BenClark1/Pulser_Driver/Project Outputs for Pulser_Driver/Pulser_Driver.xlsx

Sheet: Manufacturing
 |  | Bill of Materials for |  | Pulser_Driver.PrjPcb
 |  | Source Data From: | Pulser_Driver.PrjPcb
 |  | Variant: | None
 |  | Report Date: | 2/16/2022 12:57 PM
 |  |  |  | Primary |  |  |  |  | Secondary
Altium Vault P/N | Designator | Description | Qty | Supplier | Supplier Part Number | Manufacturer | Manufacturer Part Number | Supplier Unit Price | Supplier | Supplier Part Number | Manufacturer | Manufacturer Part Number | Supplier Unit Price
C325C201K3G5TA | C5 | Capacitor 200 pF | 1
EEU-FS2A221B | C6 | Capacitor Polarised 100VDC 220uF 1800mA EEU-FS2A221B | 1
Cap | C7, C9 | Capacitor 0.1 µF ±10% 100V Ceramic Capacitor X7R Axial SA301C104KAA, Capacitor Capacitor 0.1 µF ±10% 100V Ceramic Capacitor X7R Axial SA301C104KAA | 2
MKS2D041001K00KSSD | C8 | Capacitor | 1
MKP1839468134HQ | C10 | Capacitor MKP1839468134HQ | 1
C331C222KHR5HA | C11 | Multilayer Ceramic Capacitors MLCC - Leaded 3000V 2200pF X7R 10% LS=6.35mm | 1
EEU-TP1V121 | C12 | Capacitor Polarised | 1
C420C104K5R5TA7200 | C13 | CAP CER TH 0.1UF 50V X7R AXIAL | 1
FKP1U021006B00MSC9 | C14 | Capacitor | 1
1N5819-E3_54 | D1 | Schottky Diode | 1
1N4933G | D2 | Rectifiers 50V 1A Fast | 1
DSDI60-18A | D3 | Diode | 1
4527 | F1, F2 | Undefined or Miscellaneous | 2
57-PJ60 | J1 |  | 1
031-5640 | J3 | Connector | 1
550-2407F | LED1 | LED | 1
MTHOLE_239MIL | MT1, MT2, MT3, MT4 |  | 4
C12 | PS3 | MPN is C12, DC DC conv | 1
AM2G-1218DH30Z | PS4 |  | 1
IXBX75N170 | Q1 | Transistor IGBT | 1
CMF551K0000FKR6 | R1 | Metal Film Resistors - Through Hole 1/2W 1Kohms 1% | 1
CMF5550R000FKEK70 | R2 | Resistor 50ohm | 1
F2W2D0 | R3 | RES TH 2 OHM 5% 2W AXIAL | 1
MFR-25FBF52-14K | R4 | RES TH 14K OHM 1% 1/4W AXIAL | 1
HHV1WSJT-73-2M | R5 | RES 2M OHM 5% 1W AXIAL | 1
HB3100MFZRE | R6 | Resistor | 1
OD62GJE | R7 | Resistor | 1
T102SHCQE | SW1 | Switch | 1
1984617 | TB1, TB2 | Connector | 2
5261 | TP1, TP2, TP3, TP4, TP5, TP6, TP7, TP8, TP9, TP10, TP11 | TEST POINT grabber (BLACK) - MINIATURE | 11
MIC4452YN | U1 |  | 1
P9A1R100FISX1103MA | VR1 | Variable Resistor 10K | 1

Sheet: Project Information
Project Full Path | C:\Users\jared\Documents\senior project\Pulser_Driver\Pulser_Driver.PrjPcb
Project Filename | Pulser_Driver.PrjPcb
Variant Name | None
Data-Source Filename | Pulser_Driver.PrjPcb
Data-Source Full Path | C:\Users\jared\Documents\senior project\Pulser_Driver\Pulser_Driver.PrjPcb
Title | Bill of Materials for Project [Pulser_Driver.PrjPcb] (No PCB Document Selected)
Total Quantity | 48
Report Time | 12:57 PM
Report Date | 2/16/2022
Report Date & Tine | 2/16/2022 12:57 PM
Output Name | Bill of Materials
Output Type | BomReport
Output Generator Name | BOM
Output Generator Description | Bill of Materials
