BenClark1/Pulser_Driver/component_step_files/C331C222KHR5HA.step

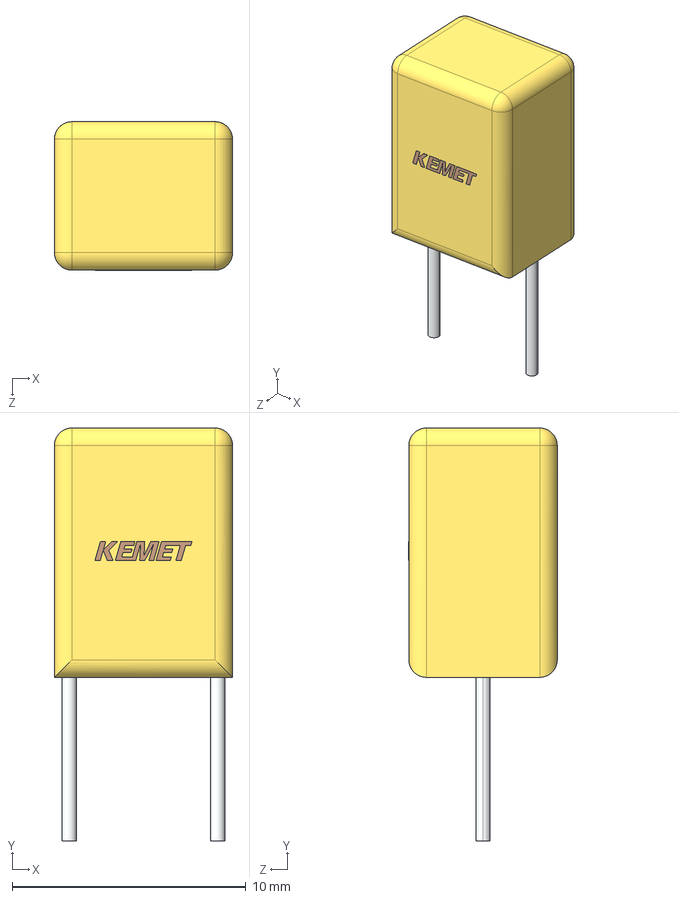
[picture p1: CAD file, 2022-02-02]
component_step_files/C331C222KHR5HA.step
7.62 x 17.7 x 6.35 mm
