BenClark1/Pulser_Driver/component_step_files/ul_MFR-25FBF52-14K/2022-01-13_22-12-16/STEP/YAG_MF25_YAG.step

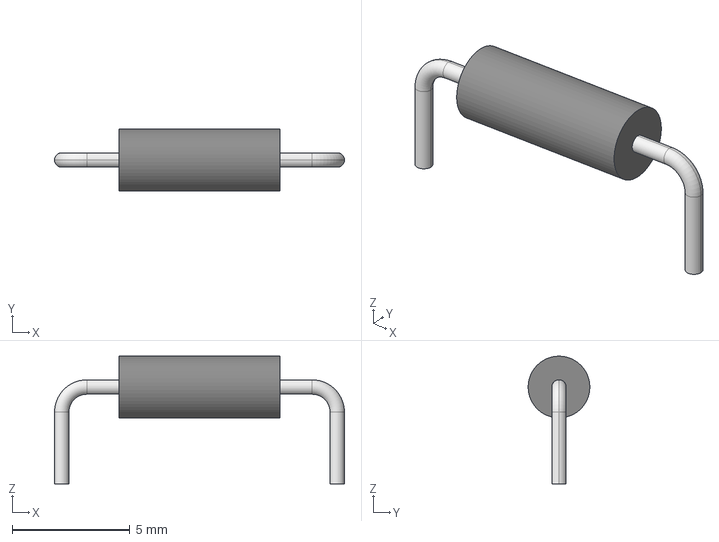
[picture p2: CAD file, 2022-01-13]
component_step_files/ul_MFR-25FBF52-14K/2022-01-13_22-12-16/STEP/YAG_MF25_YAG.step
12.3 x 2.61 x 5.41 mm
