BenClark1/Pulser_Driver/Pulser_Driver_PCB.step

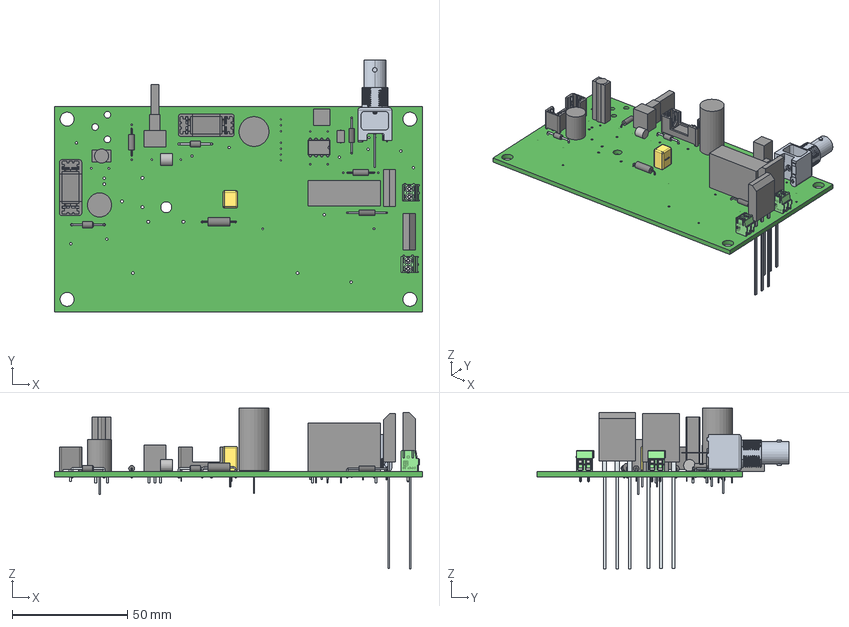
[picture p3: CAD file, 2022-02-24]
Pulser_Driver_PCB.step
159.8 x 109.3 x 69.7 mm
C331C222KHR5HA
Leads x 7
SimpleBody x 4
PinsArray x 2
YAG_MF25_YAG x 2
PinsArrayLR
YAG_HHV50_YAG
Pin1 x 2
Pin2 x 2
