BenClark1/Pulser_Driver/component_step_files/F462BY104K1L2C.step

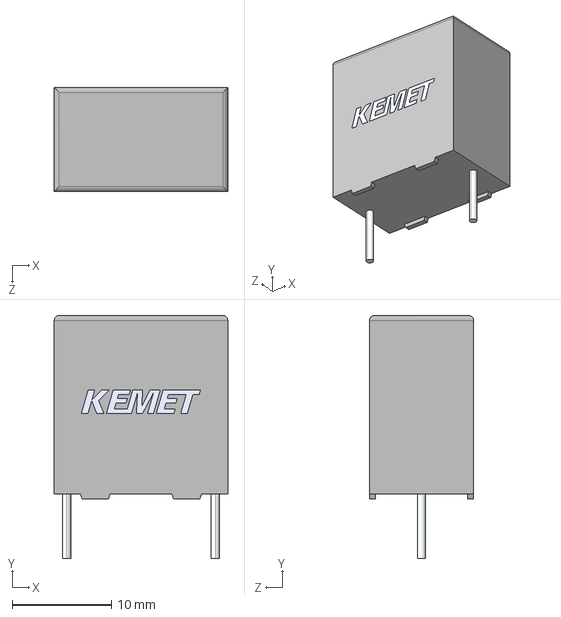
[picture p4: CAD file, 2022-02-01]
component_step_files/F462BY104K1L2C.step
17.5 x 24.5 x 10.5 mm
