BenClark1/Pulser_Driver/component_step_files/pwr220t-20.stp

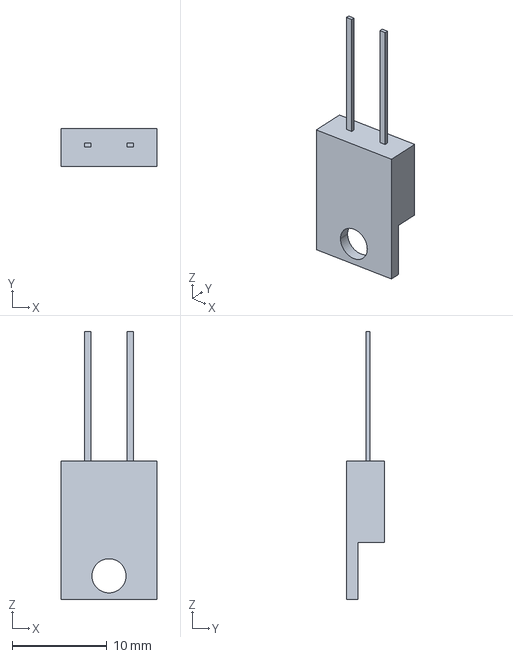
[picture p5: CAD file, 2022-01-26]
component_step_files/pwr220t-20.stp
10.1 x 4.00 x 28.3 mm
