BenClark1/Pulser_Driver/component_step_files/C420C104K5R5TA7200.step

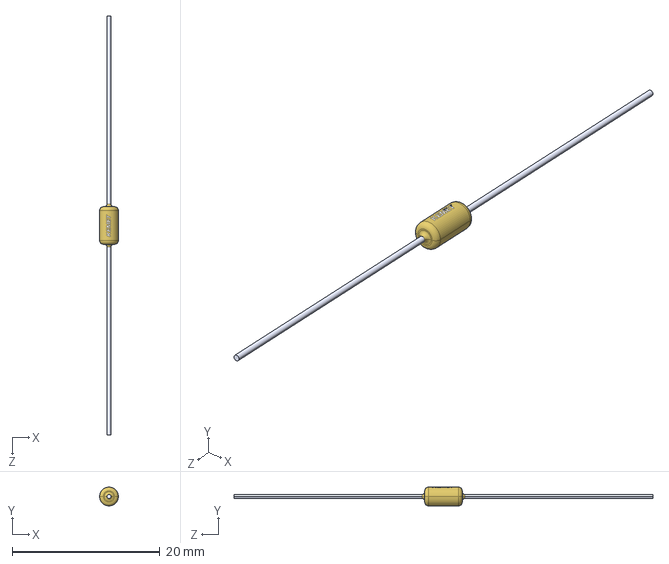
[picture p6: CAD file, 2022-01-13]
component_step_files/C420C104K5R5TA7200.step
2.54 x 2.54 x 56.6 mm
