BenClark1/Pulser_Driver/component_step_files/031-5640.stp

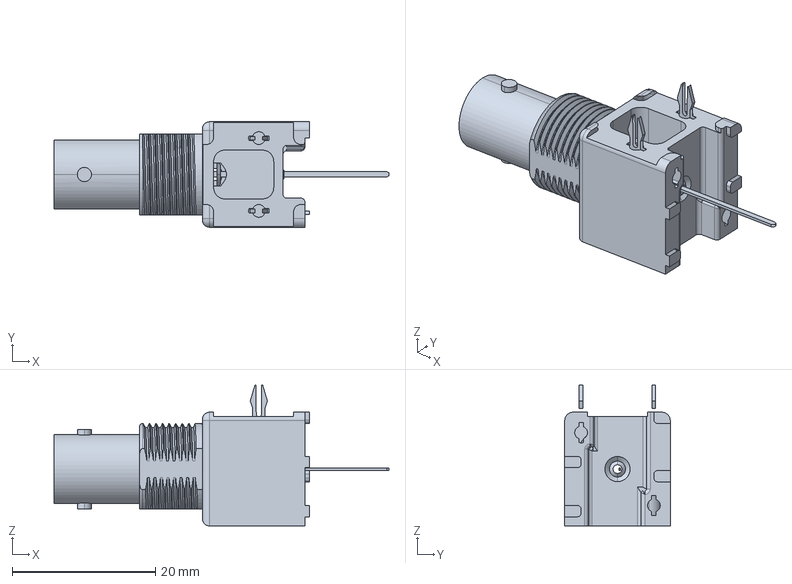
[picture p7: CAD file, 2022-01-06]
component_step_files/031-5640.stp
46.7 x 14.7 x 19.7 mm
