BenClark1/Pulser_Driver/(list of files, cad)

Other CAD files:
Pulser_Driver_PCB.DWG
