BenClark1/Pulser_Driver/Pulser_Driver.pdf

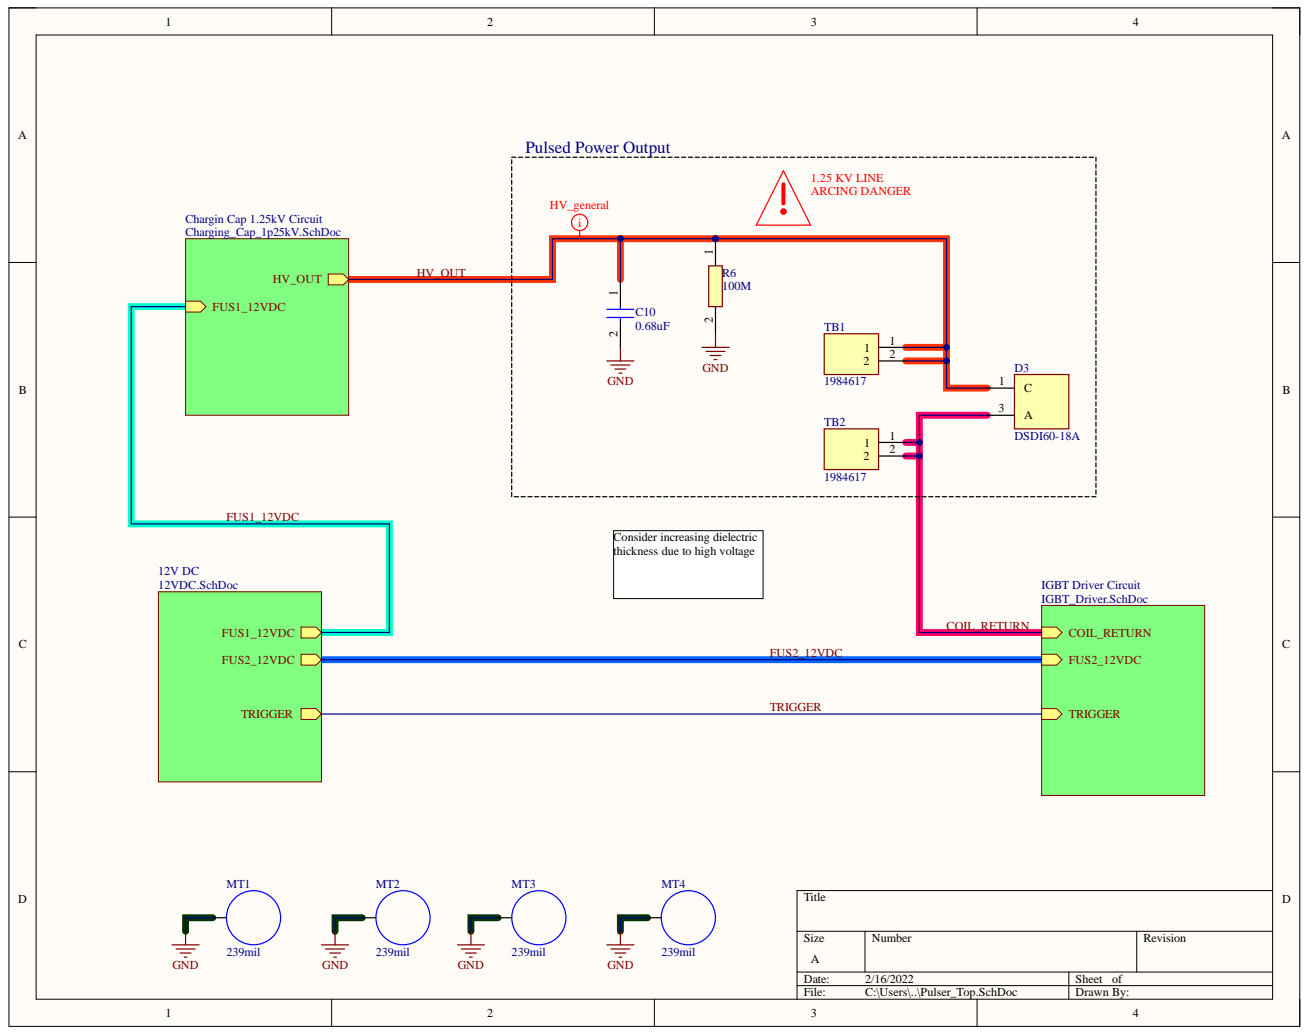
[picture p8: page 1]

Consider increasing dielectric
thickness due to high voltage

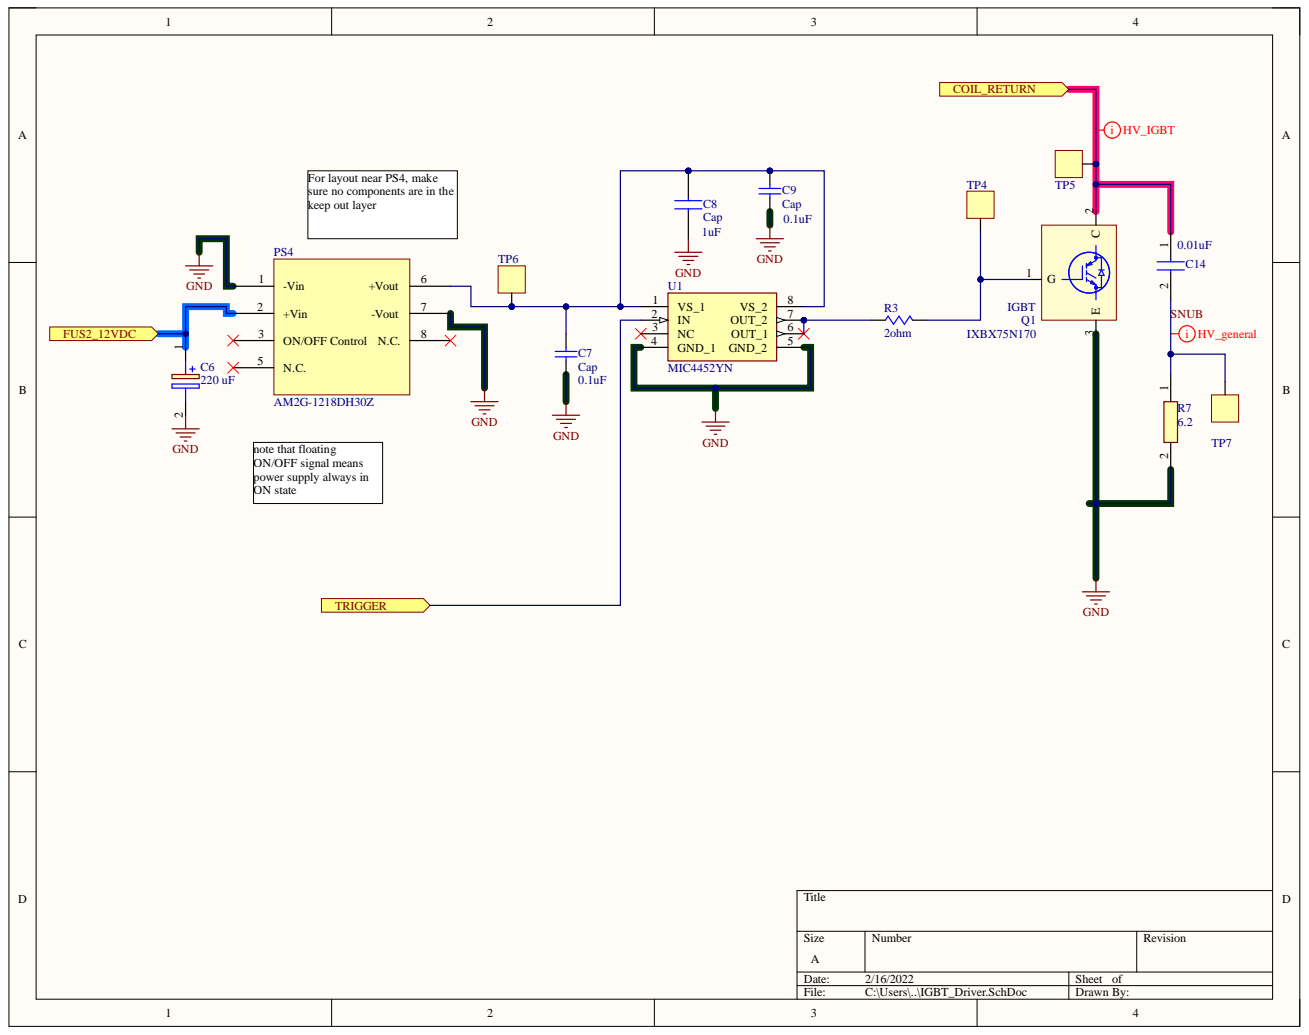
[picture p9: page 2]

For layout near PS4, make
sure no components are in the
keep out layer

note that floating
ON/OFF signal means
power supply always in
ON state

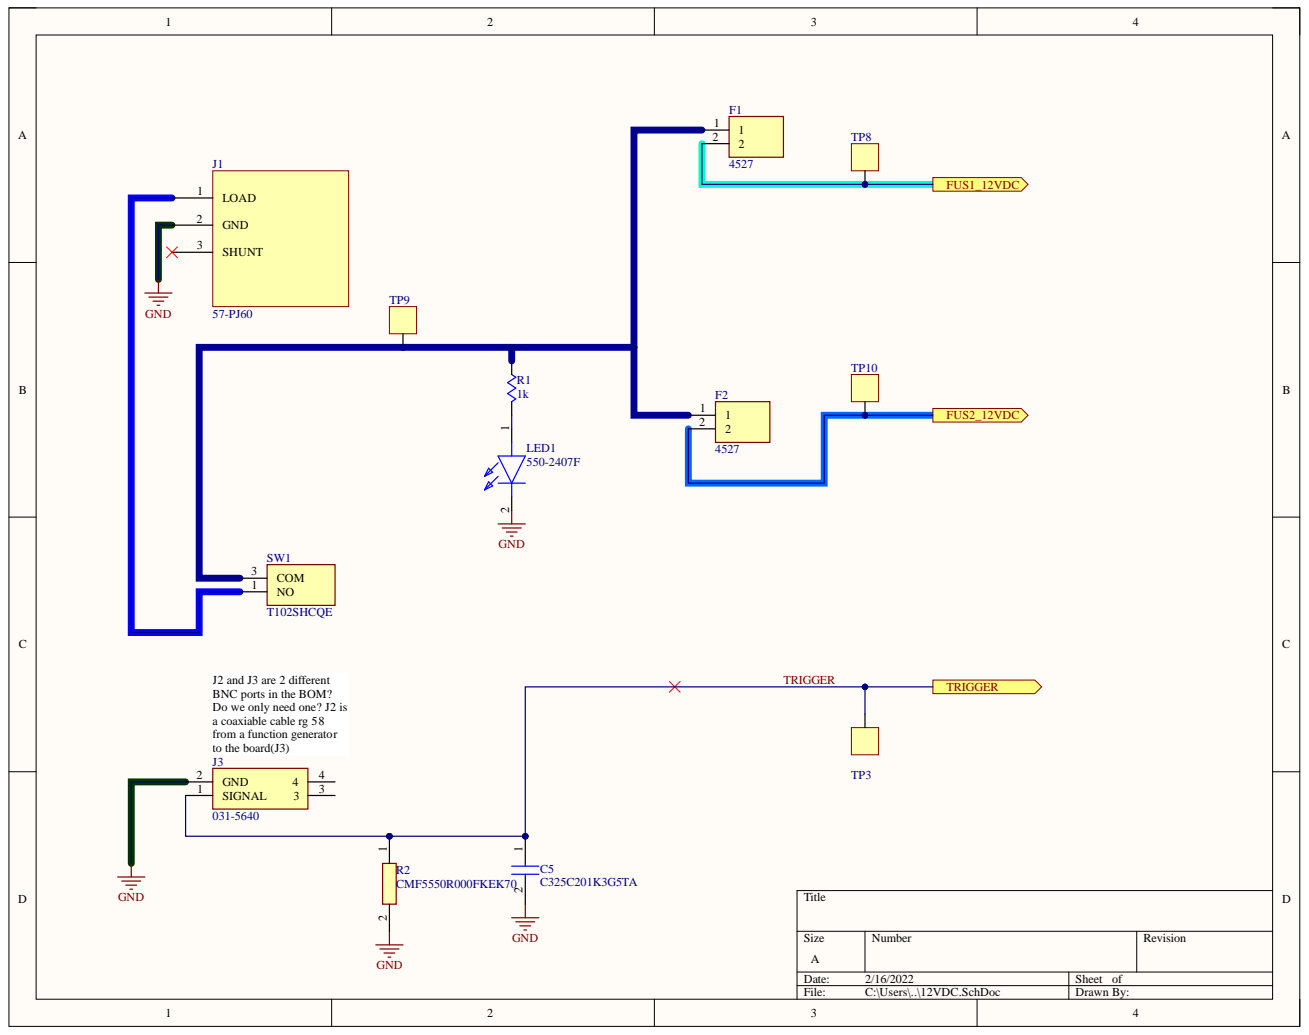
[picture p10: page 3]

J2 and J3 are 2 different
BNC ports in the BOM?
Do we only need one? J2 is
a coaxiable cable rg 58
from a function generator
to the board(J3)

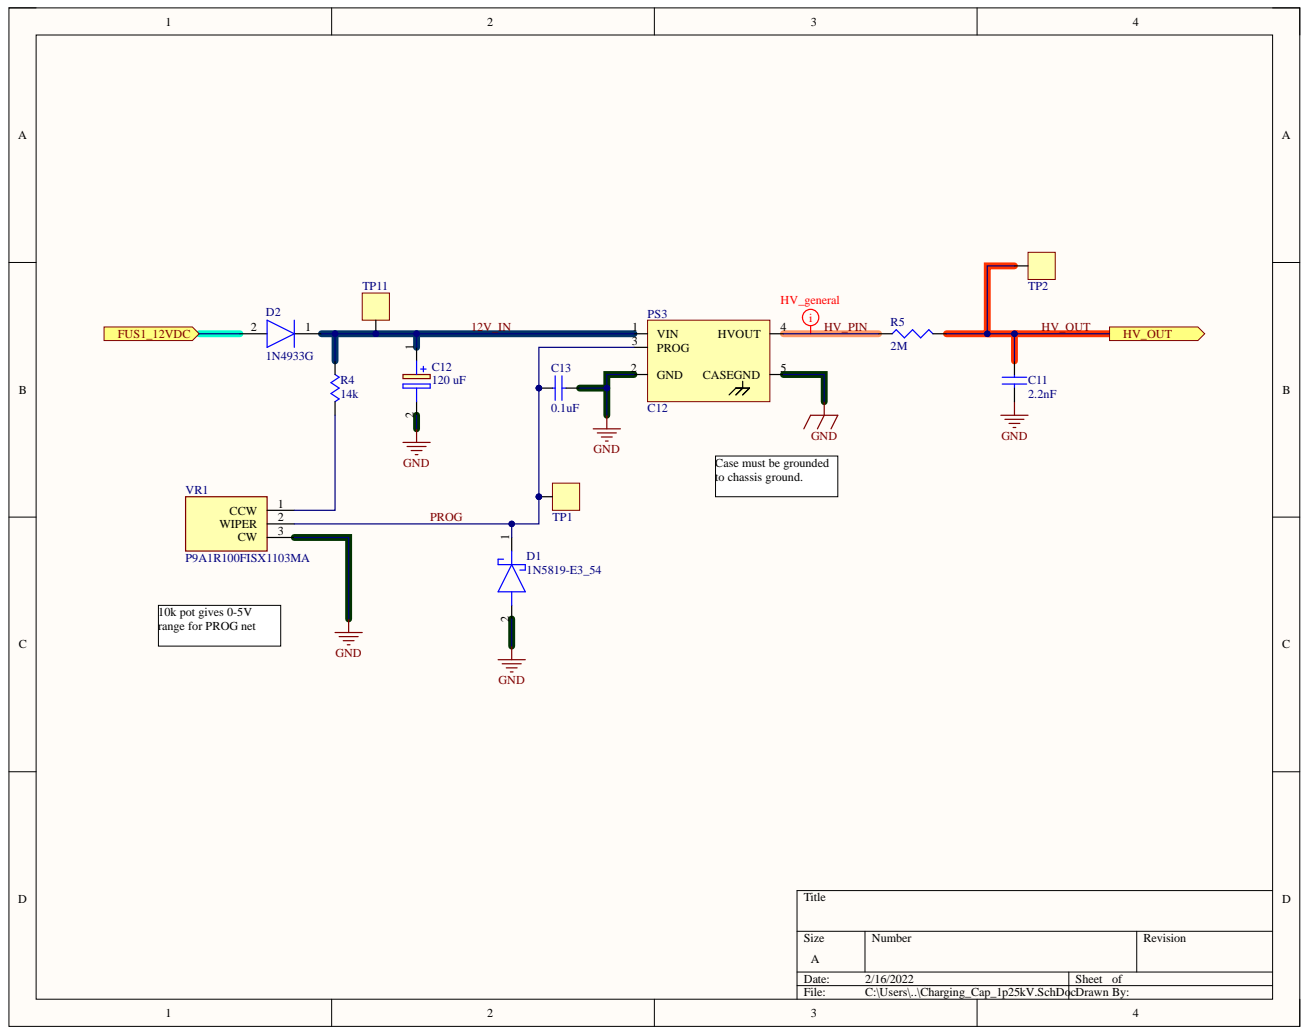
[picture p11: page 4]

Case must be grounded
to chassis ground.

10k pot gives 0-5V
range for PROG net

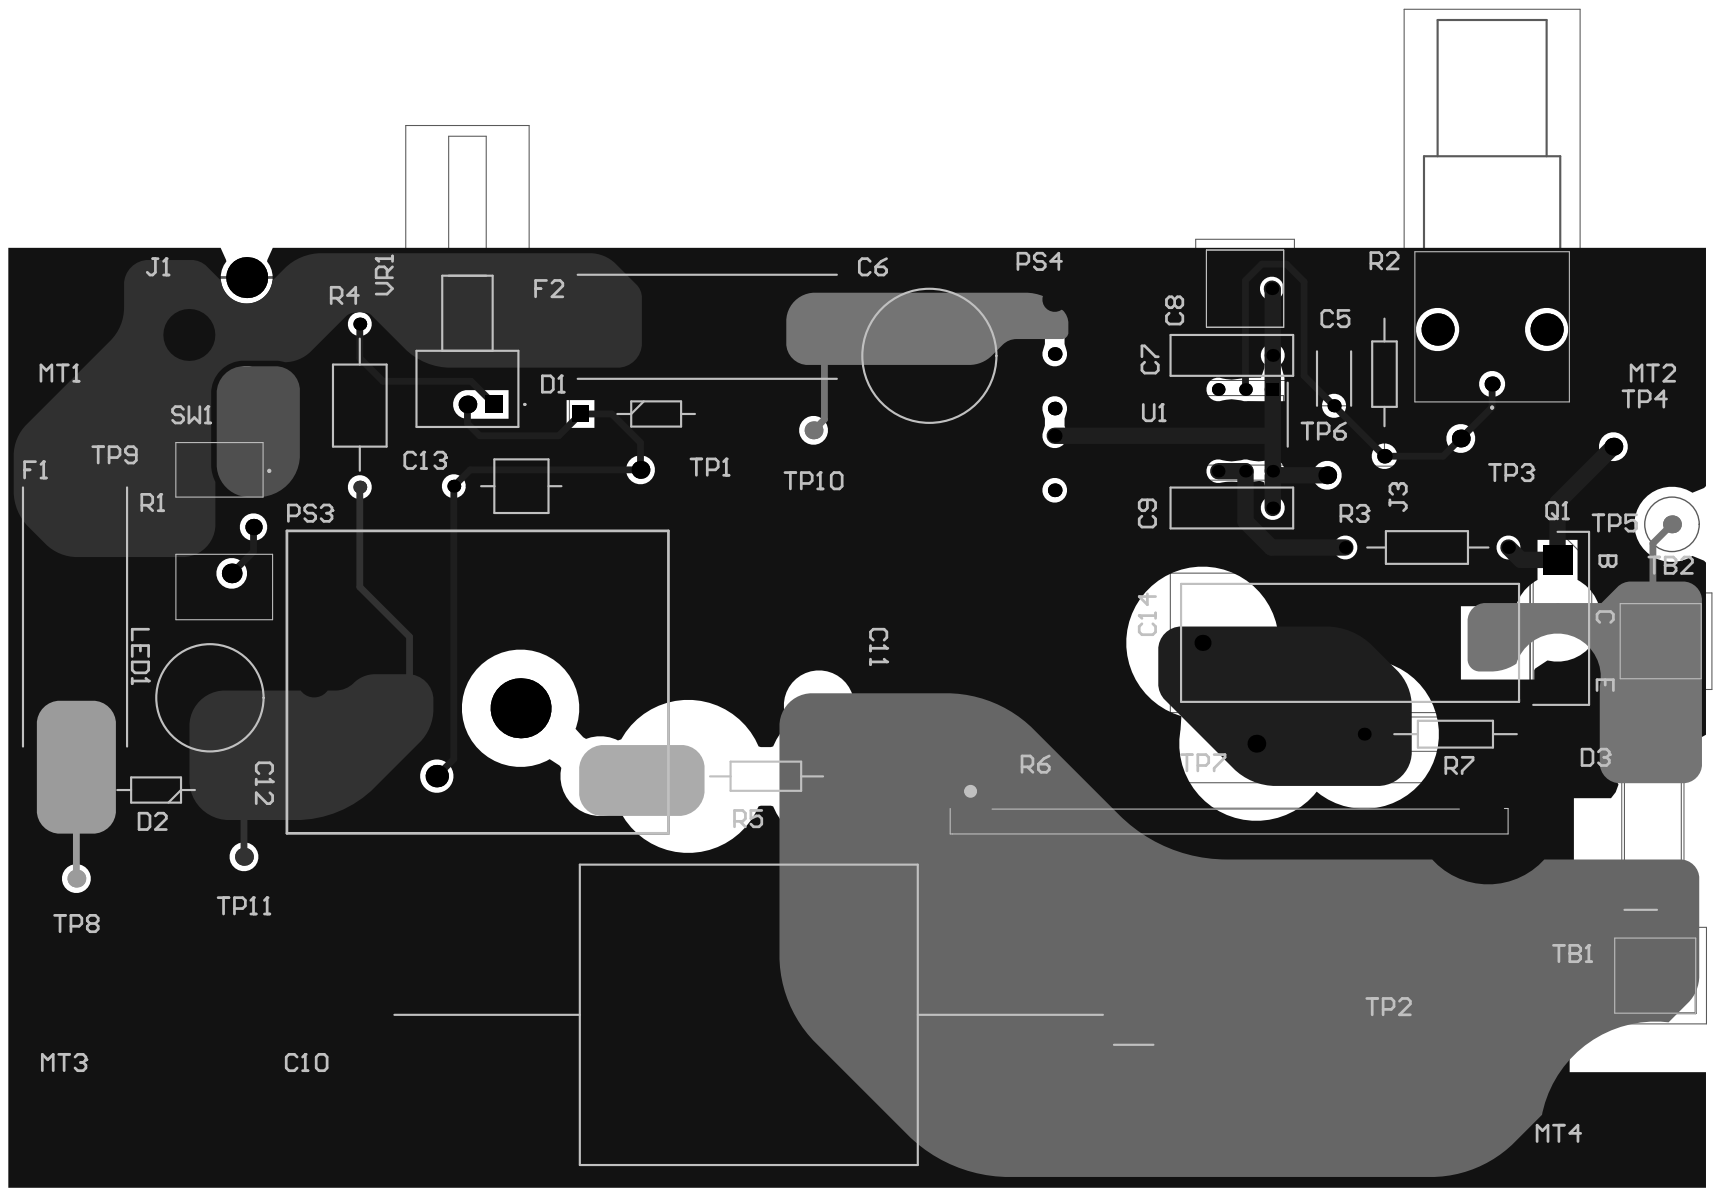
[picture p12: page 5]
