BenClark1/Pulser_Driver/(list of files, drawings)

Other design files:
12VDC.SchDoc
Charging_Cap_1p25kV.SchDoc
IGBT_Driver.SchDoc
Project Outputs for Pulser_Driver/pulser_out_3-8-22/Sources/12VDC.SchDoc
Project Outputs for Pulser_Driver/pulser_out_3-8-22/Sources/Charging_Cap_1p25kV.SchDoc
Project Outputs for Pulser_Driver/pulser_out_3-8-22/Sources/IGBT_Driver.SchDoc
Project Outputs for Pulser_Driver/pulser_out_3-8-22/Sources/Pulser_Driver.PrjPcb
Project Outputs for Pulser_Driver/pulser_out_3-8-22/Sources/pulser_driver_footprints.PcbLib
Project Outputs for Pulser_Driver/pulser_out_3-8-22/Sources/Pulser_Driver_PCB.PcbDoc
Project Outputs for Pulser_Driver/pulser_out_3-8-22/Sources/pulser_driver_symbols.SchLib
Project Outputs for Pulser_Driver/pulser_out_3-8-22/Sources/Pulser_Top.SchDoc
Project Outputs for Pulser_Driver/Sources/12VDC.SchDoc
Project Outputs for Pulser_Driver/Sources/Charging_Cap_1p25kV.SchDoc
Project Outputs for Pulser_Driver/Sources/IGBT_Driver.SchDoc
Project Outputs for Pulser_Driver/Sources/Pulser_Driver.PrjPcb
Project Outputs for Pulser_Driver/Sources/pulser_driver_footprints.PcbLib
Project Outputs for Pulser_Driver/Sources/Pulser_Driver_PCB.PcbDoc
Project Outputs for Pulser_Driver/Sources/pulser_driver_symbols.SchLib
Project Outputs for Pulser_Driver/Sources/Pulser_Top.SchDoc
Pulser_Driver_PCB.PcbDoc
