BenClark1/Pulser_Driver/Out/sizes.ini

[Page0.emf]
Pixel_PrintingWidth=6290
Pixel_PrintingHeight=4357
Mils_PrintingHeight=4357
Mils_PrintingWidth=6290
[Page1.emf]
Pixel_PrintingWidth=6290
Pixel_PrintingHeight=4357
Mils_PrintingHeight=4357
Mils_PrintingWidth=6290
