BenClark1/Pulser_Driver/(commit log)

2021-10-27 Initial creation of project repo
    [12VDC.SchDoc, IGBT_Driver.SchDoc, Pulser_Driver.PrjPcb, Pulser_Top.SchDoc, pulse_pwr_out.SchDoc]
2021-10-27 auto add PrjPcbStructure file
    [Pulser_Driver.PrjPcb]
2021-11-02 added charging_cap file
    [Charging_Cap_1p25kV.SchDoc, Pulser_Driver.PrjPcb]
2021-11-04 still testing
    [Charging_Cap_1p25kV.SchDoc]
2021-11-09 push from thrusday
    [Charging_Cap_1p25kV.SchDoc]
2021-11-18 started on charging cap
    [Charging_Cap_1p25kV.SchDoc]
2021-11-18 finished components and connections for charging_cap sheet
    [Charging_Cap_1p25kV.SchDoc, IGBT_Driver.SchDoc]
2021-11-18 add ps4 to schematic
    [IGBT_Driver.SchDoc]
2021-11-20 finished charging_cap mostly, added nets and ports and one IGBT
    [12VDC.SchDoc, Charging_Cap_1p25kV.SchDoc, IGBT_Driver.SchDoc, Pulser_Driver.PrjPcb, Pulser_Top.SchDoc, pulse_pwr_out.SchDoc]
2021-11-24 updates to 12vdc and igbtdriver
    [12VDC.SchDoc, IGBT_Driver.SchDoc, Pulser_Top.SchDoc]
2021-11-29 added ref des for igbt sheet, added some net colors
    [12VDC.SchDoc, IGBT_Driver.SchDoc]
2021-12-20 added wall junction to 12vdc
    [12VDC.SchDoc]
2022-01-01 finalized schematic, placed cap, ref des
    [12VDC.SchDoc, IGBT_Driver.SchDoc, Pulser_Top.SchDoc]
2022-01-01 created new symbol/footprint libraries in version control
    [Charging_Cap_1p25kV.SchDoc, Pulser_Driver_PCB.PcbDoc, Pulser_Top.SchDoc, pulser_driver_footprints.PcbLib, pulser_driver_symbols.SchLib]
2022-01-01 minor schematic changes
    [Charging_Cap_1p25kV.SchDoc, Pulser_Driver.PrjPcb]
2022-01-02 created and started layout file
    [12VDC.SchDoc, Charging_Cap_1p25kV.SchDoc, IGBT_Driver.SchDoc, Pulser_Driver.PrjPcb, Pulser_Driver_PCB.PcbDoc, Pulser_Top.SchDoc, pulser_driver_footprints.PcbLib, pulser_driver_symbols.SchLib]
2022-01-04 check j3
    [12VDC.SchDoc, pulser_driver_footprints.PcbLib, pulser_driver_symbols.SchLib]
2022-01-04 fixed components
    [12VDC.SchDoc, Charging_Cap_1p25kV.SchDoc, IGBT_Driver.SchDoc, pulser_driver_footprints.PcbLib, pulser_driver_symbols.SchLib]
2022-01-04 part replaced updated layout
    [Pulser_Driver_PCB.PcbDoc]
2022-01-05 added bleed resistor
    [12VDC.SchDoc, Pulser_Driver_PCB.PcbDoc, Pulser_Top.SchDoc, pulser_driver_footprints.PcbLib, pulser_driver_symbols.SchLib]
2022-01-06 moved LED upstream of fuses, did ~60% of layout placement, no routing yet
    [031-5640.stp, 12VDC.SchDoc, Charging_Cap_1p25kV.SchDoc, IGBT_Driver.SchDoc, Pulser_Driver.PrjPcb, Pulser_Driver_PCB.PcbDoc, Pulser_Top.SchDoc, pulser_driver_footprints.PcbLib]
2022-01-07 layout adds
    [Pulser_Driver_PCB.PcbDoc, Pulser_Top.SchDoc]
2022-01-07 started routing beginning with 12vdc stuff and charging cap
    [Pulser_Driver.PrjPcb, Pulser_Driver_PCB.PcbDoc, Pulser_Top.SchDoc, pulser_driver_footprints.PcbLib]
2022-01-10 changed r4 other components and added traces to trigger side
    [12VDC.SchDoc, Charging_Cap_1p25kV.SchDoc, IGBT_Driver.SchDoc, Pulser_Driver_PCB.PcbDoc, pulser_driver_footprints.PcbLib, pulser_driver_symbols.SchLib]
2022-01-11 added planes, updated ps4 footprint
    [Pulser_Driver_PCB.PcbDoc, pulser_driver_footprints.PcbLib]
2022-01-11 changed a few traces and added one gnd connection
    [pulser_driver_footprints.PcbLib]
2022-01-12 finalized layout planes and fixed c6 again, updated silk
    [12VDC.SchDoc, Charging_Cap_1p25kV.SchDoc, IGBT_Driver.SchDoc, Pulser_Driver.PrjPcb, Pulser_Driver_PCB.PcbDoc, Pulser_Top.SchDoc, pulser_driver_footprints.PcbLib]
2022-01-13 replaced SM with TH in schematic but not layout
    [C420C104K5R5TA7200.step, Charging_Cap_1p25kV.SchDoc, IGBT_Driver.SchDoc, YAG_MF25_YAG.step, pulser_driver_footprints.PcbLib, pulser_driver_symbols.SchLib]
2022-01-18 updated 4 new TH components, changed planes
    [Charging_Cap_1p25kV.SchDoc, IGBT_Driver.SchDoc, Pulser_Driver.PrjPcb, Pulser_Driver_PCB.PcbDoc, pulser_driver_footprints.PcbLib]
2022-01-18 added 2 ohm resistor to library
    [IGBT_Driver.SchDoc, pulser_driver_footprints.PcbLib, pulser_driver_symbols.SchLib]
2022-01-19 add snub resistors
    [IGBT_Driver.SchDoc, Pulser_Driver.PrjPcb, Pulser_Driver_PCB.PcbDoc, pulser_driver_footprints.PcbLib, pulser_driver_symbols.SchLib]
2022-01-20 added mounting holes
    [Charging_Cap_1p25kV.SchDoc, Pulser_Driver.PrjPcb, Pulser_Driver_PCB.PcbDoc, Pulser_Top.SchDoc, pulser_driver_footprints.PcbLib, pulser_driver_symbols.SchLib]
2022-01-24 placed mounting holes and snubber circuit in layout, more routing to do
    [Pulser_Driver_PCB.PcbDoc, pulser_driver_footprints.PcbLib]
2022-01-26 final routing, still need to replace snubber resistors
    [Pulser_Driver.PrjPcb, Pulser_Driver_PCB.PcbDoc, pulser_driver_footprints.PcbLib, pwr220t-20.stp]
2022-01-26 add diode clamprs
    [Pulser_Driver_PCB.PcbDoc, Pulser_Top.SchDoc, pulser_driver_footprints.PcbLib, pulser_driver_symbols.SchLib]
2022-01-27 created pdf of schematics
    [Pulser_Driver.PrjPcb]
2022-02-01 added new snubber parts and found net class issue in layout, needs fixing
    [F462BY104K1L2C.step, IGBT_Driver.SchDoc, Pulser_Driver.PrjPcb, Pulser_Driver_PCB.PcbDoc, pulser_driver_footprints.PcbLib, pulser_driver_symbols.SchLib]
2022-02-01 fixed net class issue, finalized layout and silkscreen, got to 0 DRC errors
    [12VDC.SchDoc, Charging_Cap_1p25kV.SchDoc, IGBT_Driver.SchDoc, Pulser_Driver.PrjPcb, Pulser_Driver_PCB.PcbDoc, Pulser_Top.SchDoc, pulser_driver_footprints.PcbLib, pulser_driver_symbols.SchLib]
2022-02-02 replaced 2.2nF cap with in-stock version
    [C331C222KHR5HA.step, Charging_Cap_1p25kV.SchDoc, Pulser_Driver_PCB.PcbDoc, Pulser_Top.SchDoc, pulser_driver_footprints.PcbLib, pulser_driver_symbols.SchLib]
2022-02-04 add snub replace
    [12VDC.SchDoc, Charging_Cap_1p25kV.SchDoc, IGBT_Driver.SchDoc, Pulser_Driver.PrjPcb, Pulser_Driver_PCB.PcbDoc, pulser_driver_footprints.PcbLib, pulser_driver_symbols.SchLib]
2022-02-07 updated design rules, added test points, touch ups on traces/planes
    [12VDC.SchDoc, Charging_Cap_1p25kV.SchDoc, IGBT_Driver.SchDoc, Pulser_Driver.PrjPcb, Pulser_Driver_PCB.PcbDoc, Pulser_Top.SchDoc, pulser_driver_footprints.PcbLib]
2022-02-09 updated design rules for 250mil HV clearance, still need to update HV planes for this
    [Pulser_Driver_PCB.PcbDoc]
2022-02-15 fixed clearance rules and created rule exceptions for two footprints (cap and HV boost converter)
    [Pulser_Driver_PCB.PcbDoc]
2022-02-21 increased board edge clearance to match trace spacing, added gnd plane cutouts
    [Pulser_Driver_PCB.PcbDoc]
2022-02-22 split ground planes, still some DRC errors to fix
    [Charging_Cap_1p25kV.SchDoc, IGBT_Driver.SchDoc, Pulser_Driver.PrjPcb, Pulser_Driver_PCB.PcbDoc, Pulser_Top.SchDoc, pulser_driver_footprints.PcbLib, pulser_driver_symbols.SchLib]
2022-02-23 replaced c6 still need to place
    [IGBT_Driver.SchDoc, Pulser_Driver.PrjPcb, Pulser_Driver.xls, Pulser_Driver.xlsx, Pulser_Driver_PCB.DWG, Pulser_Driver_PCB.PcbDoc, Pulser_Driver_PCB.step, pulser_driver_footprints.PcbLib]
2022-02-24 replaced c6
    [Pulser_Driver_PCB.PcbDoc]
2022-02-25 fixed DRCs, added silk names
    [Pulser_Driver_PCB.PcbDoc]
2022-02-25 had to save prjpcb file
    [Pulser_Driver.PrjPcb]
2022-02-27 removed one of the net ties so that there is only one
    [Charging_Cap_1p25kV.SchDoc, IGBT_Driver.SchDoc, Pulser_Driver_PCB.PcbDoc, Pulser_Top.SchDoc]
2022-03-01 added PCBPN and started figuring out outputs
    [Pulser_Driver_PCB.PcbDoc, Pulser_Top.SchDoc]
2022-03-03 added fab/assy outjob files
    [Pulser_Driver.PrjPcb]
2022-03-03 removed assy file as we're doing all assembly ourselves
    [Pulser_Driver.PrjPcb]
2022-03-03 created odb++ about to release project
    [Pulser_Driver.PrjPcb]
2022-03-04 configured fab / output files for quoting purposes
    [12VDC.SchDoc, Bill of Materials-Pulser_Driver.xls, Charging_Cap_1p25kV.SchDoc, IGBT_Driver.SchDoc, Pulser_Driver.PrjPcb, Pulser_Driver_PCB.PcbDoc, Pulser_Driver_PCB.xls, Pulser_Top.SchDoc]
2022-03-08 regenerated ODB++ files
    [IGBT_Driver.SchDoc]
2022-03-08 hit save on release file
    [Pulser_Driver.PrjPcb]
2022-03-08 re-released output files and placed order, still pending payment info
    [12VDC.SchDoc, Bill of Materials-Pulser_Driver.xls, Charging_Cap_1p25kV.SchDoc, IGBT_Driver.SchDoc, Pulser_Driver.PrjPcb, Pulser_Driver_PCB.PcbDoc, Pulser_Driver_PCB.xls, Pulser_Top.SchDoc]
2022-03-08 rereleasing because vendor issue: multiple odb file sets in zip folder
    [12VDC.SchDoc, Bill of Materials-Pulser_Driver.xls, Charging_Cap_1p25kV.SchDoc, IGBT_Driver.SchDoc, Pulser_Driver.PrjPcb, Pulser_Driver_PCB.PcbDoc, Pulser_Driver_PCB.xls, Pulser_Top.SchDoc]
2022-03-08 added output zip
    [12VDC.SchDoc, Charging_Cap_1p25kV.SchDoc, IGBT_Driver.SchDoc, Pulser_Driver.PrjPcb, Pulser_Driver_PCB.PcbDoc, Pulser_Driver_PCB.xls, Pulser_Top.SchDoc, pulser_driver_footprints.PcbLib]
2022-03-09 checking for 0mil holes, turned out to be in net tie component I made, was explained to Sierra
    [Pulser_Driver_PCB.PcbDoc]
2022-04-01 added note about VIH and VIL for trigger line
    [IGBT_Driver.SchDoc]
2022-04-14 added note about pot voltage and EMCO output
    [Charging_Cap_1p25kV.SchDoc]
2022-05-14 added note about 12V connecter being backwards
    [12VDC.SchDoc]
2022-05-14 negligable changes to IGBT_driver sheet
    [IGBT_Driver.SchDoc]
